jaw0/usb-crypto-jawn/img/top.jpg

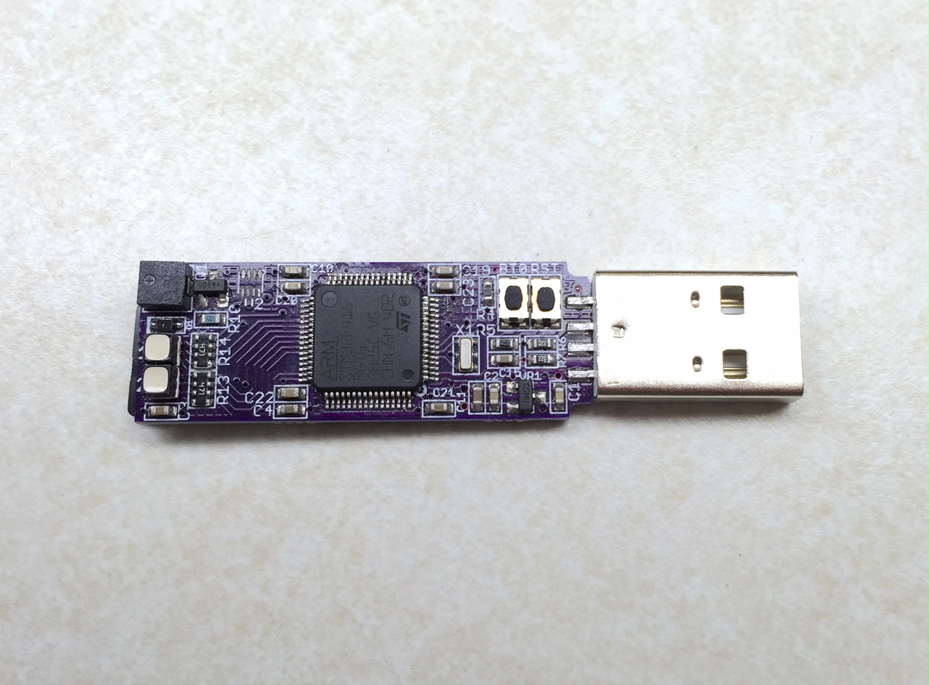
img/top.jpg
