jaw0/usb-crypto-jawn/img/bot.jpg

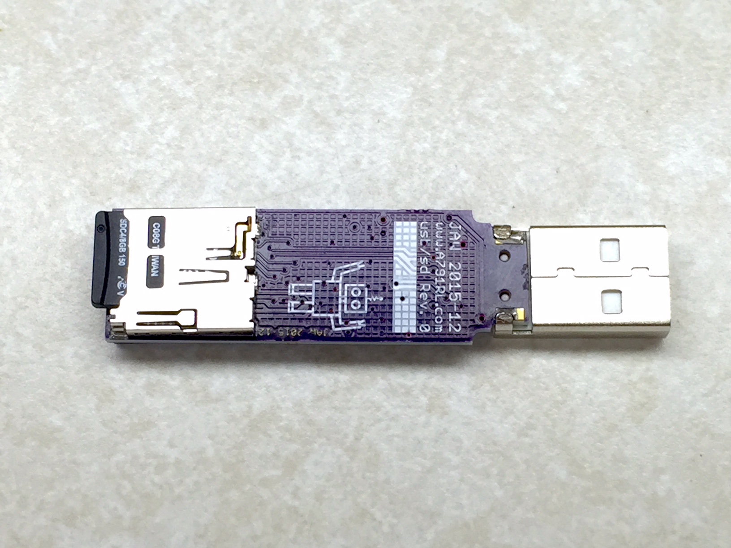
img/bot.jpg
