jaw0/usb-crypto-jawn/README.md

Hardware encryption, sd card, and usb port.

The current firmware implements an encrypted
"usb stick".

Like [Bitlocker](http://css.csail.mit.edu/6.858/2013/readings/bitlocker.pdf),
but with the addition of per disk-block IVs + MACs.
