jaw0/usb-crypto-jawn/(threads)

Thread 1 (2017-09-17):

What is the status of this project?

NIXOYE, 2017-09-17:
Can't seem to find any updates about the project. I'm interested in knowing how useable this project is and if any problems rise when trying to use this open source usb

jaw0, 2017-09-19:
there are no issues with the hardware, it works as expected.
the usb works, the sd card works, the hardware crypto works.

on the other hand, I haven't been able to get ST's usb software
to do all of things I want to do.

NIXOYE, 2017-09-19:
What other things are you trying to get it to do? Also is there a guide on building one and a BOM?

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

NIXOYE, 2017-10-05:
also @jaw0 would you be willing to sell any premade jawns?

Thread 2 (2017-12-06):

I'm ordering some crypto jawns from PCBWAY will I need to solder the section that connects to computers?

NIXOYE, 2017-12-06:
It doesn't seem like the brd file includes the USB section that will connect to the computer so when I make the Gerber and BOM to import to http://pcbway.com I don't think they'll know to include the usb part. Am I going to need to order the crypto jawn and then solder the usb part myself?

jaw0, 2017-12-06:
I don't know anything about "pcbway", but the schematic shows that the usb connector is molex part 480371000

NIXOYE, 2018-01-22:
after getting one soldered and everything what else is required to get it working? any software or programming required? @jaw0

Thread 4 (2018-03-23):

Missing components from exported BOM

jawnmon, 2018-03-23:
in red

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
