jaw0/usb-crypto-jawn/cad/cryptojawn.brd

## EAGLE design cad/cryptojawn.brd (2019-02-20)

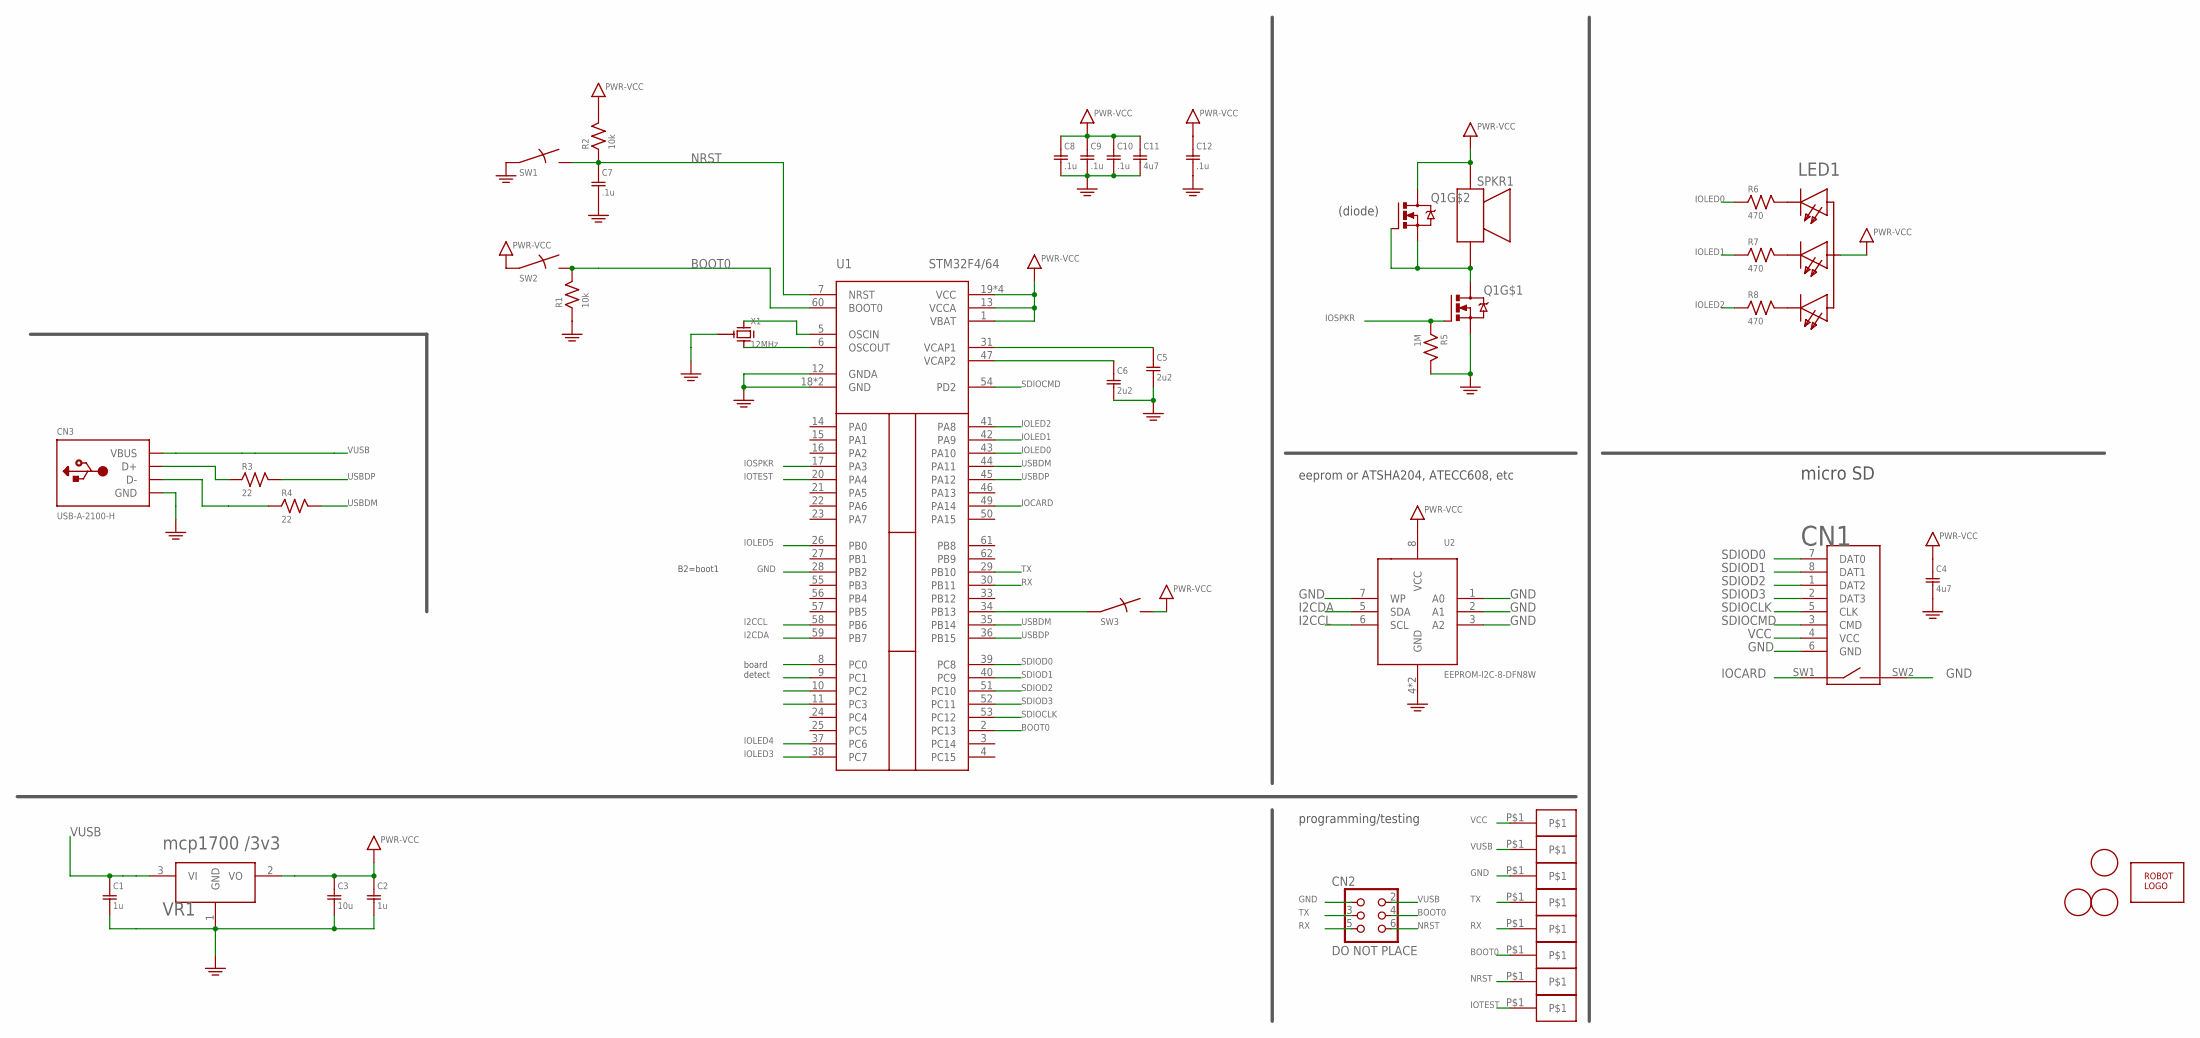
[picture p3: schematic cryptojawn.sch]

Parts:
C1, C2: 1u; SMD0603
C3: 10u; SMD0603
C4, C11: 4u7; SMD0603
C5, C6: 2u2; SMD0603
C7, C8, C9, C10, C12: .1u; SMD0603
CN1: MICROSDPLAIN; MICROSD/MOLEX/FRONT/PLAIN
CN2: DO NOT PLACE; HEADER-3X2-PTH1.27
CN3: USB-A-2100-H; MOLEX_480372100-HOLE
CN4, CN5, CN6, CN7, CN8, CN9, CN10, CN11: HEADER-1X1-SPOT; SPOT
LED1: LED-RGB-CA-PLCC4; PLCC4-3228
Q1: DMN63D8LDW; SC-70-6
R1, R2: 10k; SMD0603
R3, R4: 22; SMD0603
R5: 1M; SMD0603
R6, R7, R8: 470; SMD0603
SPKR1: SPKR-PUI-0440; PUI-0440
SW1, SW2, SW3: SWITCH-PTS810; PTS810
U1: STM32F4/64; TQFP64
U2: EEPROM-I2C-8-DFN8W; TDFN8EPW
U$1: ROBOTMAN-LOGO
U$2, U$3, U$4: FIDUCIAL; FIDUCIAL_1MM
VR1: mcp1700 /3v3; SOT-23-3@1
X1: 12MHz; RESONATOR-CSTCE

Connections:
BOOT0: CN2.4, CN8.P$1, R1.2, SW2.P$2, SW2.P$2B, U1.2 (PC13), U1.60 (BOOT0)
GND: C1.2, C2.2, C3.2, C4.2, C5.2, C6.2, C7.2, C8.2, C9.2, C10.2, C11.2, C12.2, CN1.6 (GND), CN1.SW2, CN2.1, CN3.4 (GND), CN3.P$1 (GND), CN3.P$2 (GND), CN5.P$1, Q1.1 (S), R1.1, R5.2, SW1.P$1, SW1.P$1B, U1.12 (GNDA), U1.18 (GND), U1.28 (PB2), U1.63 (GND), U2.1 (A0), U2.2 (A1), U2.3 (A2), U2.4 (GND), U2.7 (WP), U2.PAD (GND), VR1.1 (GND), X1.2 (G)
I2CCL: U1.58 (PB6), U2.6 (SCL)
I2CDA: U1.59 (PB7), U2.5 (SDA)
IOCARD: CN1.SW1, U1.49 (PA14)
IOLED0: R6.1, U1.43 (PA10)
IOLED1: R7.1, U1.42 (PA9)
IOLED2: R8.1, U1.41 (PA8)
IOLED3: U1.38 (PC7)
IOLED4: U1.37 (PC6)
IOLED5: U1.26 (PB0)
IOSPKR: Q1.2 (G), R5.1, U1.17 (PA3)
IOTEST: CN11.P$1, U1.20 (PA4)
unnamed: LED1.P$4 (CB), R7.2
unnamed: SW3.P$1, SW3.P$1B, U1.34 (PB13)
unnamed: LED1.P$2 (CR), R8.2
unnamed: C6.1, U1.47 (VCAP2)
unnamed: LED1.P$3 (CG), R6.2
unnamed: CN3.2 (D-), R4.1
unnamed: CN3.3 (D+), R3.1
unnamed: U1.5 (OSCIN), X1.1 (X1)
unnamed: U1.6 (OSCOUT), X1.3 (X2)
unnamed: Q1.4 (S), Q1.5 (G), Q1.6 (D), SPKR1.P$2 (P2)
unnamed: C5.1, U1.31 (VCAP1)
NRST: C7.1, CN2.6, CN9.P$1, R2.1, SW1.P$2, SW1.P$2B, U1.7 (NRST)
RX: CN2.5, CN7.P$1, U1.30 (PB11)
SDIOCLK: CN1.5 (CLK), U1.53 (PC12)
SDIOCMD: CN1.3 (CMD), U1.54 (PD2)
SDIOD0: CN1.7 (DAT0), U1.39 (PC8)
SDIOD1: CN1.8 (DAT1), U1.40 (PC9)
SDIOD2: CN1.1 (DAT2), U1.51 (PC10)
SDIOD3: CN1.2 (DAT3), U1.52 (PC11)
TX: CN2.3, CN6.P$1, U1.29 (PB10)
USBDM: R4.2, U1.35 (PB14), U1.44 (PA11)
USBDP: R3.2, U1.36 (PB15), U1.45 (PA12)
VCC: C2.1, C3.1, C4.1, C8.1, C9.1, C10.1, C11.1, C12.1, CN1.4 (VCC), CN10.P$1, LED1.P$1 (A), Q1.3 (D), R2.2, SPKR1.P$1 (P1), SW2.P$1, SW2.P$1B, SW3.P$2, SW3.P$2B, U1.1 (VBAT), U1.13 (VCCA), U1.19 (VCC), U1.32 (VCC), U1.48 (VCC), U1.64 (VCC), U2.8 (VCC), VR1.2 (VO)
VUSB: C1.1, CN2.2, CN3.1 (VBUS), CN4.P$1, VR1.3 (VI)

Notes on the sheet:
micro SD
eeprom or ATSHA204, ATECC608, etc
programming/testing
(diode)
B2=boot1
board detect

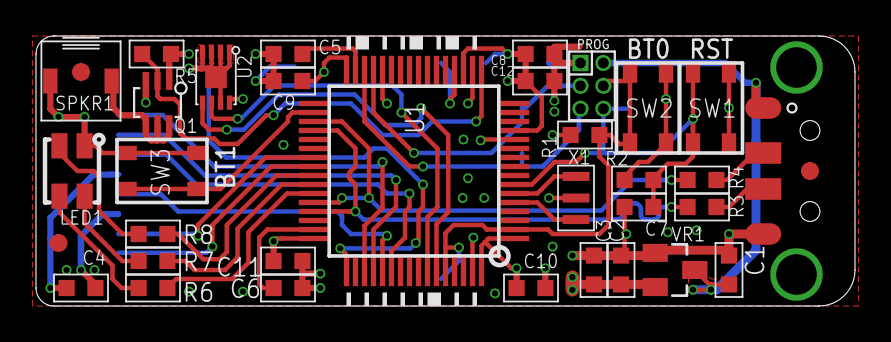
[picture p4: board cryptojawn.brd from above]

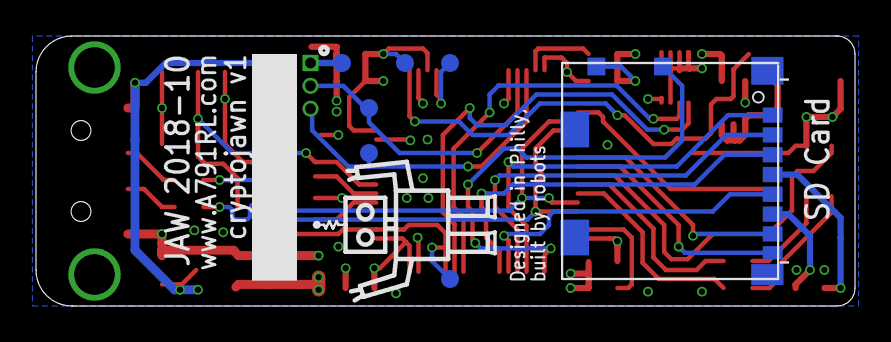
[picture p5: board cryptojawn.brd from below]

Board: 4 copper layers, 45.5 x 15.0 mm, 45 parts (10 on the bottom side), 34 nets.
