jaw0/usb-crypto-jawn/cad/cj-buttons.brd

## EAGLE design cad/cj-buttons.brd (2019-02-20)

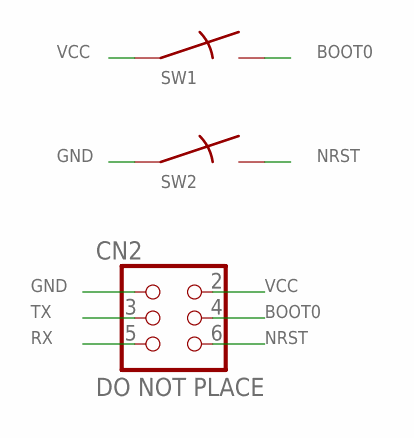
[picture p6: schematic cj-buttons.sch]

Parts:
CN2: DO NOT PLACE; HEADER-3X2-PTH1.27
SW1, SW2: SWITCHKMR211; KMR211

Connections:
BOOT0: CN2.4, SW1.2, SW1.4
GND: CN2.1, SW2.1, SW2.3
NRST: CN2.6, SW2.2, SW2.4
RX: CN2.5
TX: CN2.3
VCC: CN2.2, SW1.1, SW1.3

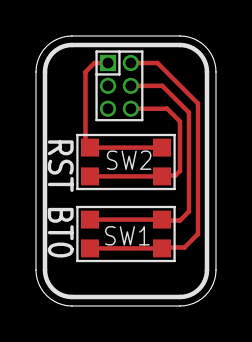
[picture p7: board cj-buttons.brd from above]

Board: 2 copper layers, 10.0 x 15.0 mm, 3 parts (0 on the bottom side), 4 nets.
