jaw0/usb-crypto-jawn/(commit log)

2015-12-11 2*rgb led, etc
    [usb415.brd, usb415.sch]
2015-12-12 reverse polarity
    [usb415.brd, usb415.sch]
2016-01-15 sd connector
    [usb415.brd, usb415.sch]
2016-01-21 add prog/test header
    [usb415.brd, usb415.sch]
2018-10-01 rename file
    [cryptojawn.brd, cryptojawn.sch]
2018-10-01 hardware rev.1
    [cryptojawn.brd, cryptojawn.sch]
2019-02-20 mini board
    [cj-buttons.brd, cj-buttons.sch, cj-mini.brd, cj-mini.sch, cj732.brd, cj732.sch]
